tboneATL/covid-19-response/media/31mar1.png

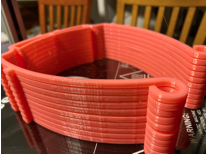
media/31mar1.png
