tboneATL/covid-19-response/media/GMT2.jpg

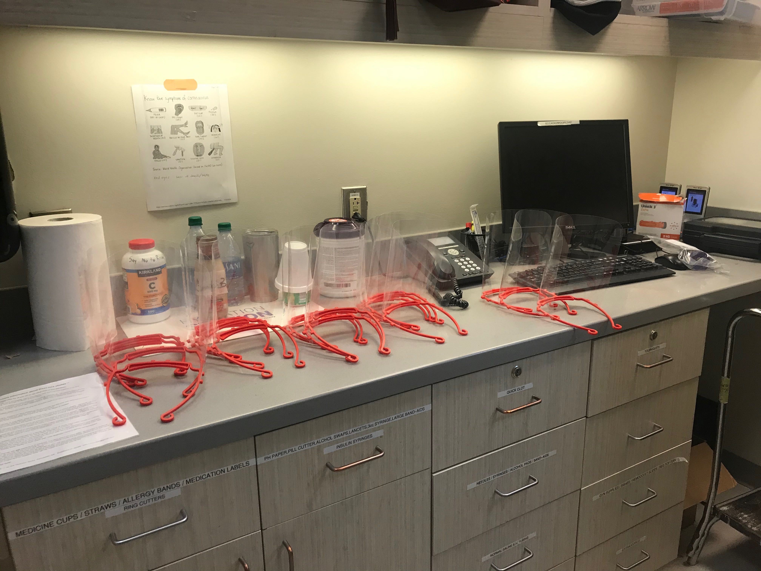
media/GMT2.jpg
