tboneATL/covid-19-response/README.md

# Be safe



## Please visit https://tboneatl.github.io/covid-19-response/ to understand what this is and what this isn't before printing/distributing anything from this repo.
