tboneATL/covid-19-response/shield-designs-for-cutting/Face-Shield-v2.pdf

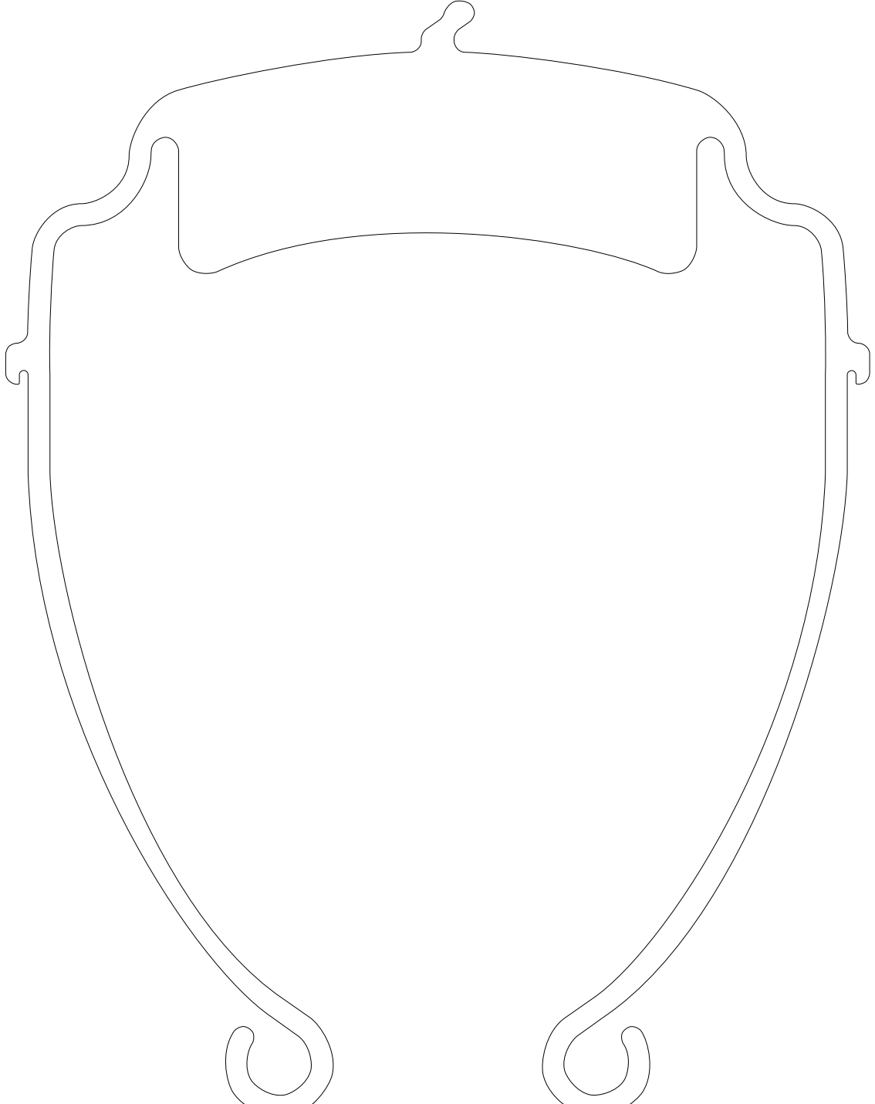
[picture p3: figure]
