tboneATL/covid-19-response/media/1apr.png

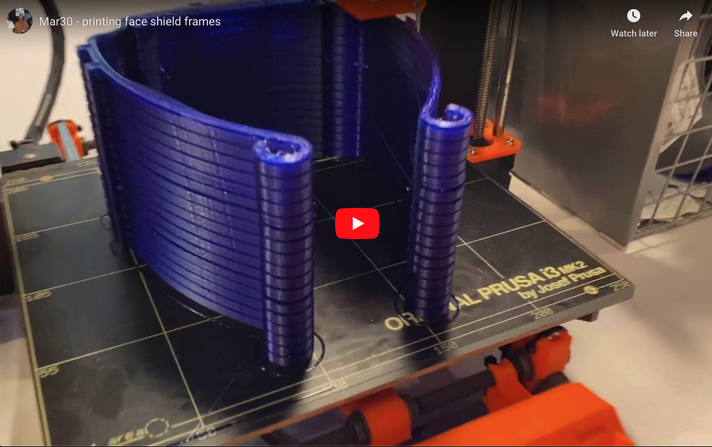
media/1apr.png
