tboneATL/covid-19-response/media/19mar.png

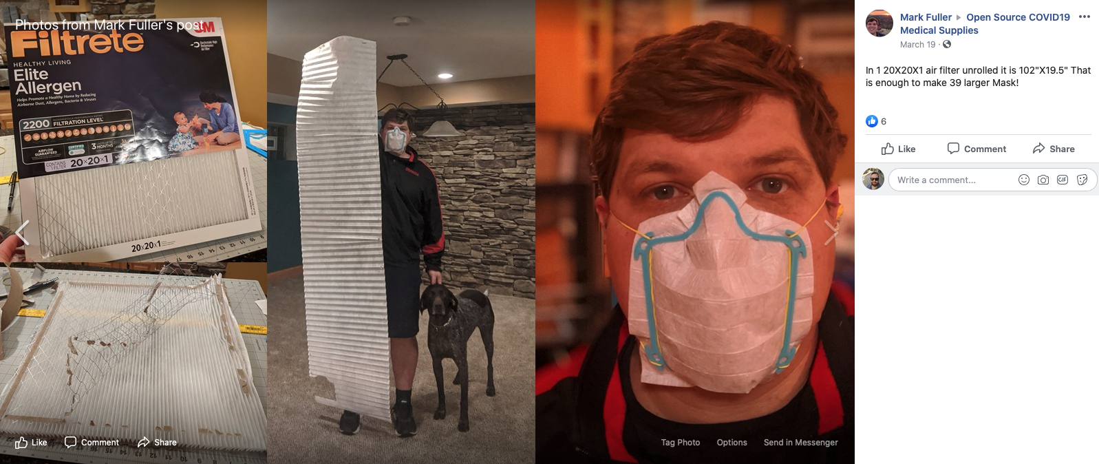
media/19mar.png
