tboneATL/covid-19-response/media/27mar1.png

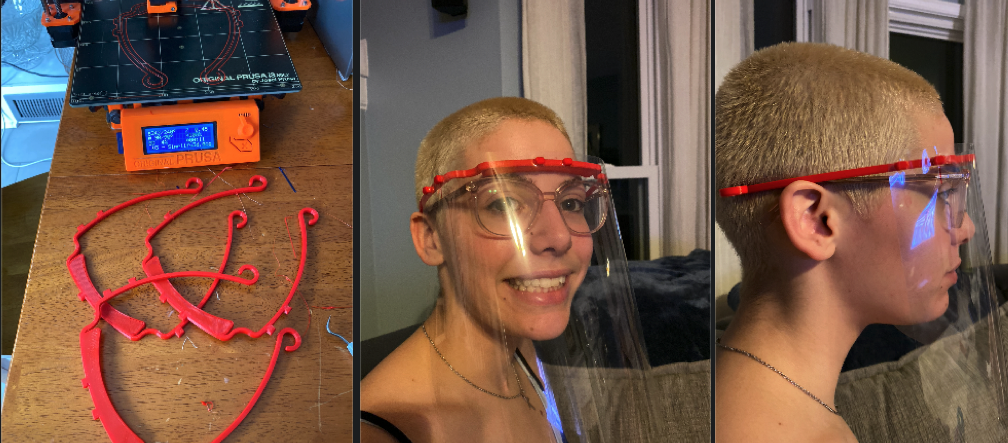
media/27mar1.png
