tboneATL/covid-19-response/media/27mar2.png

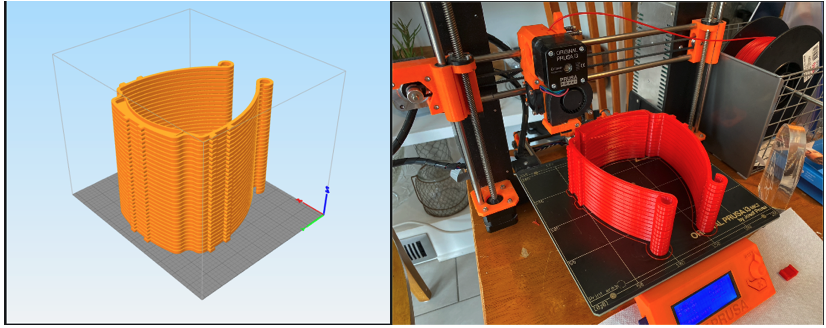
media/27mar2.png
