tboneATL/covid-19-response/media/28mar1.png

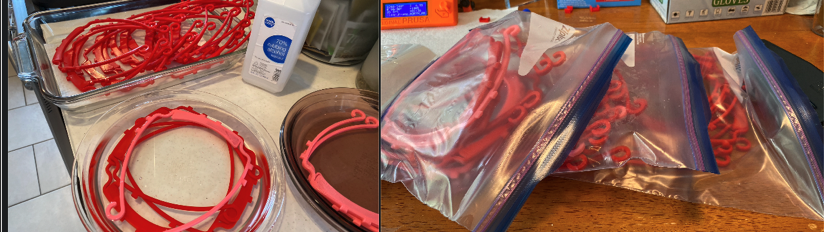
media/28mar1.png
