tboneATL/covid-19-response/media/28mar2.png

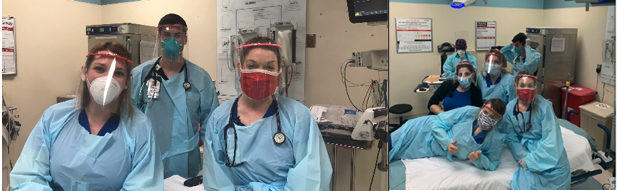
media/28mar2.png
