tboneATL/covid-19-response/media/29mar1.png

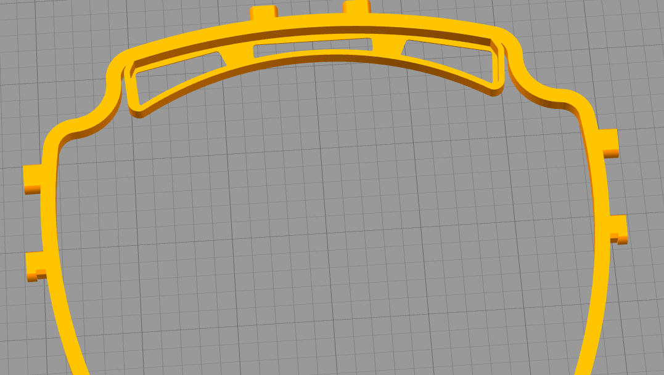
media/29mar1.png
