tboneATL/covid-19-response/media/29mar2.png

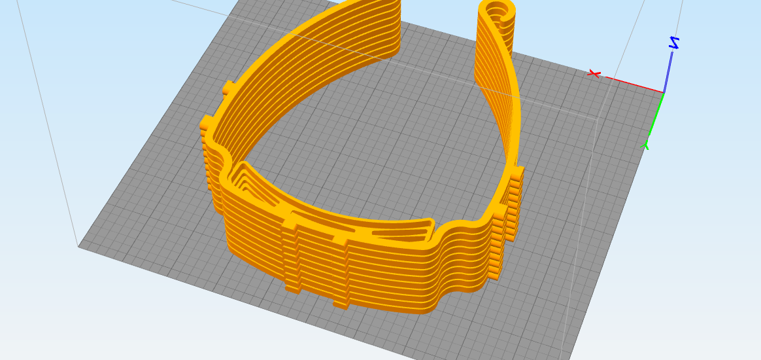
media/29mar2.png
