tboneATL/covid-19-response/media/30mar1.png

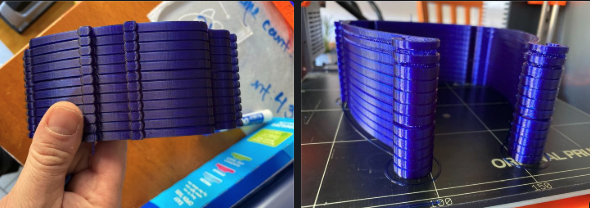
media/30mar1.png
