tboneATL/covid-19-response/media/30mar2.png

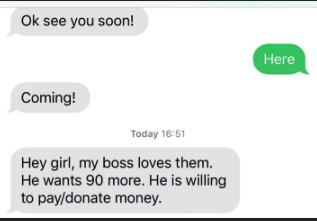
media/30mar2.png
