tboneATL/covid-19-response/media/30mar3.png

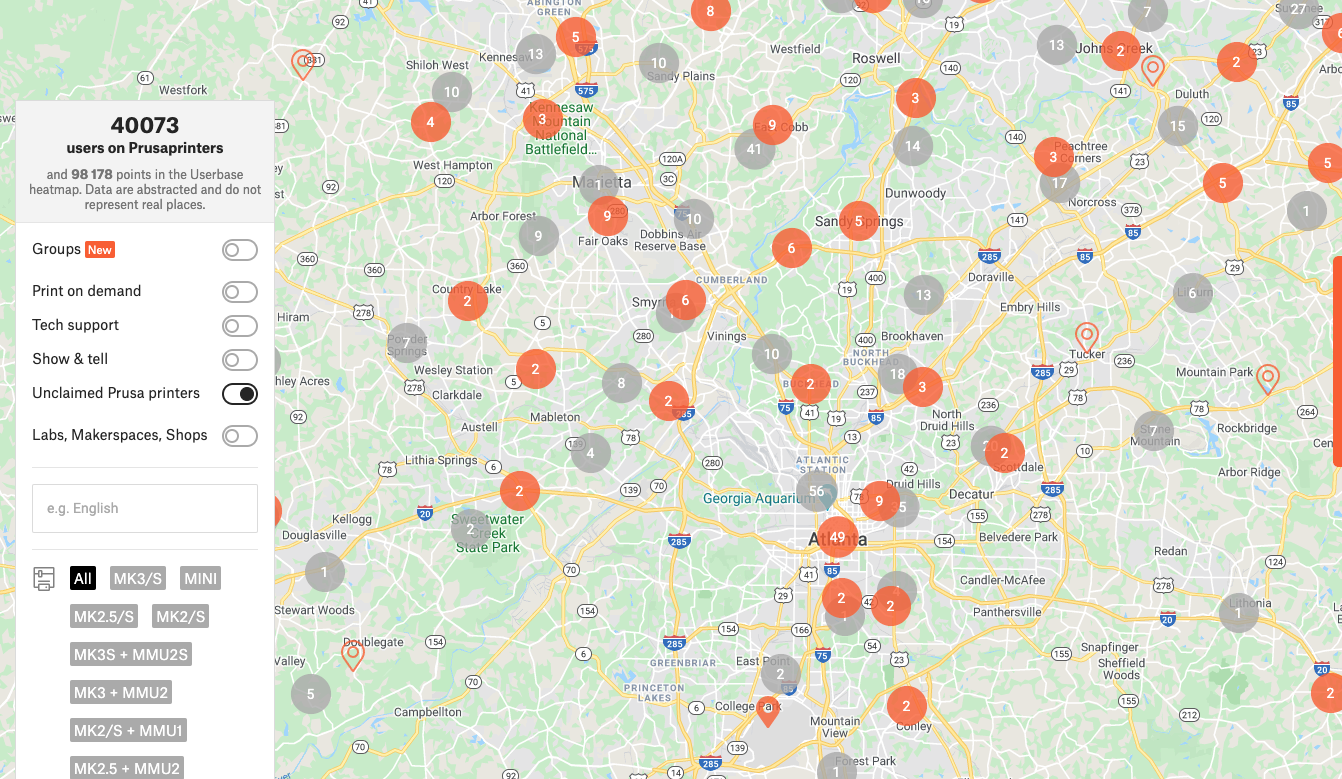
media/30mar3.png
