tboneATL/covid-19-response/media/31mar2.png

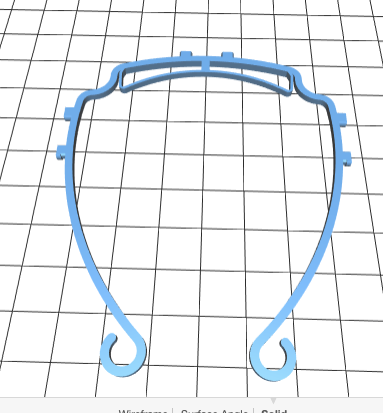
media/31mar2.png
