tboneATL/covid-19-response/media/31mar3.png

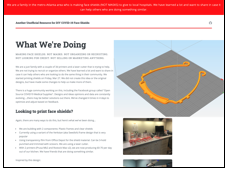
media/31mar3.png
