tboneATL/covid-19-response/media/GMT1.jpg

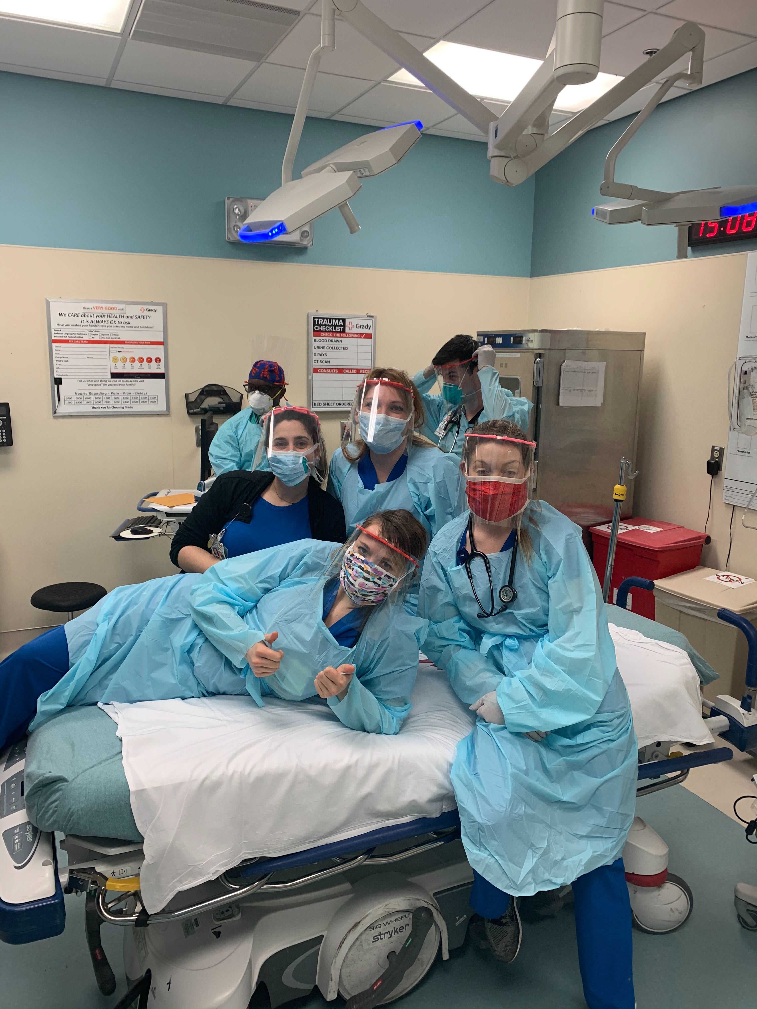
media/GMT1.jpg
