tboneATL/covid-19-response/media/GMT3.jpg

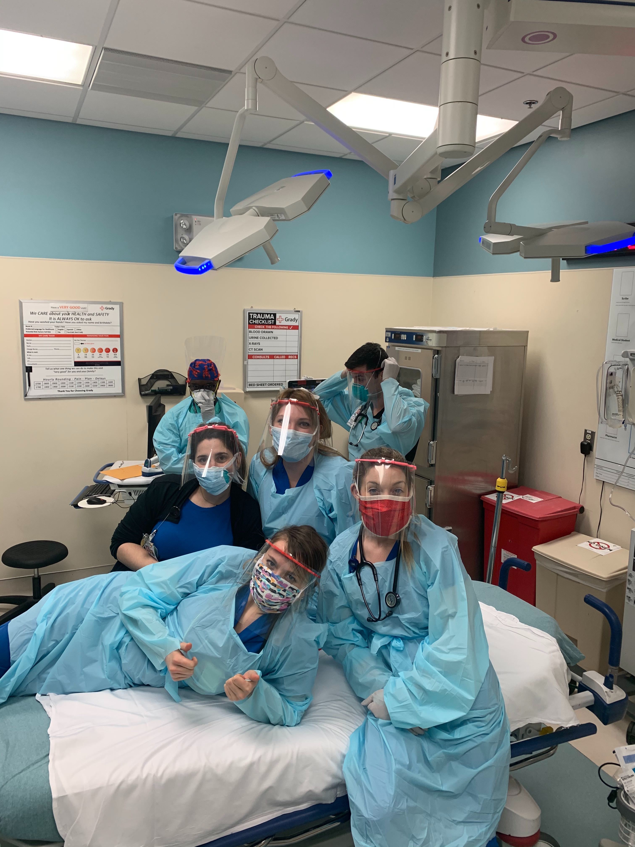
media/GMT3.jpg
