tboneATL/covid-19-response/media/GMT4.jpg

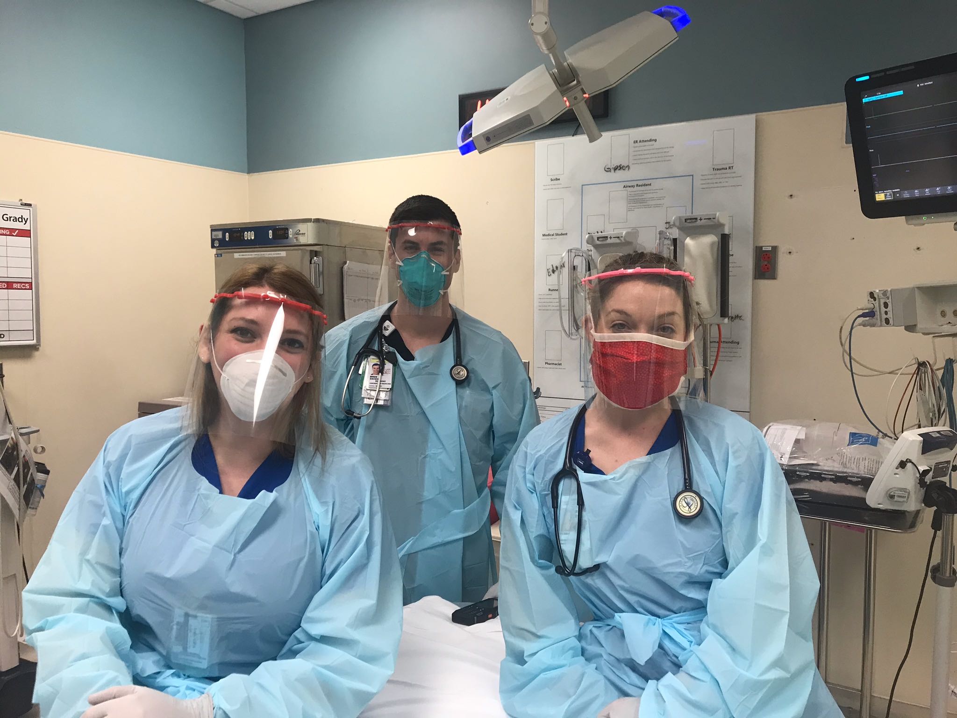
media/GMT4.jpg
