tboneATL/covid-19-response/media/protoshield.png

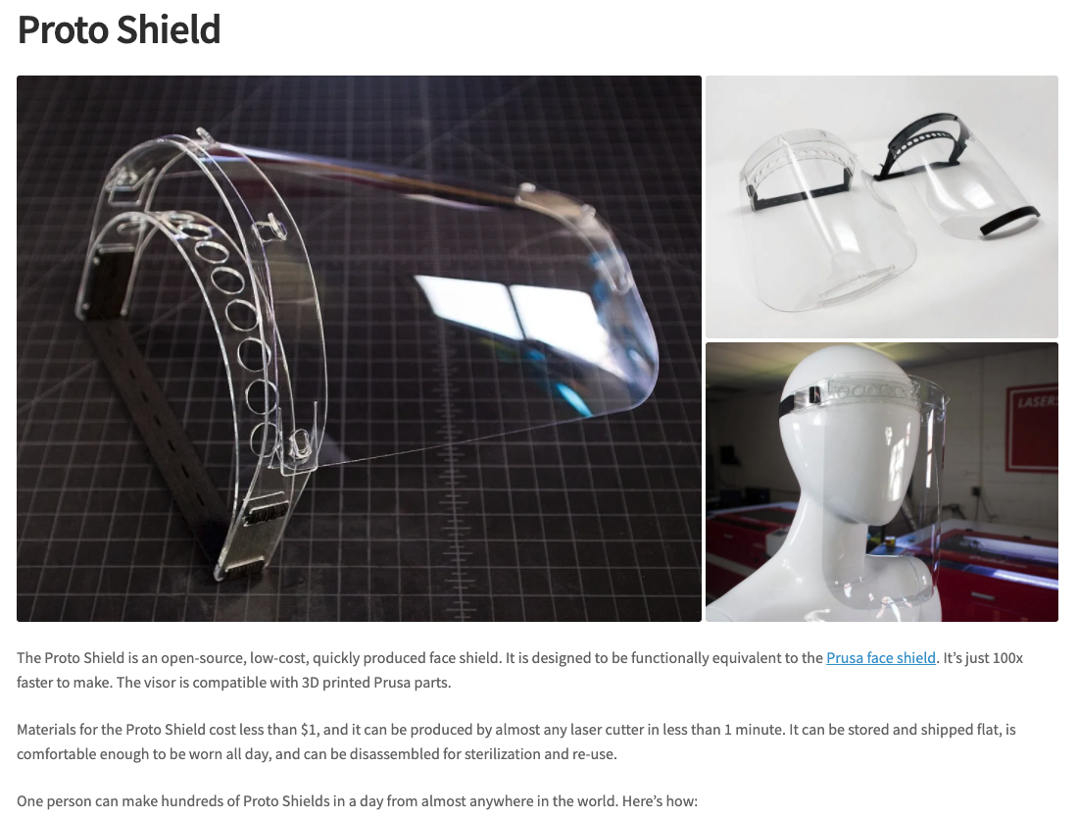
media/protoshield.png
