tboneATL/covid-19-response/media/prusaRC3img.png

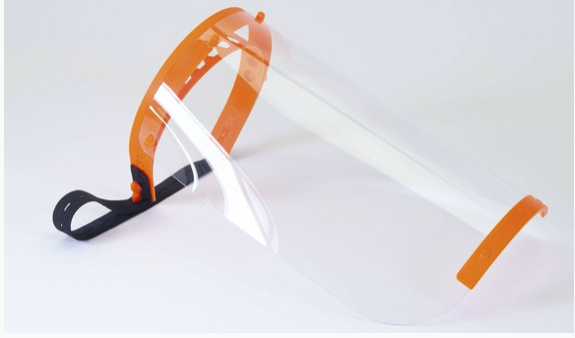
media/prusaRC3img.png
