tboneATL/covid-19-response/media/THS4.jpg

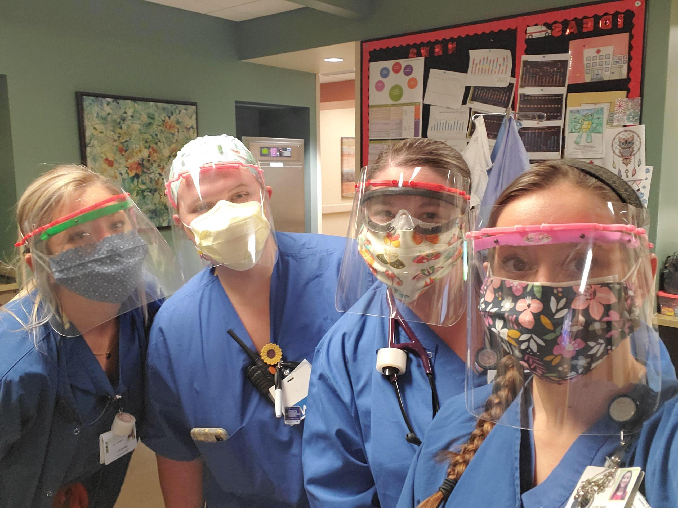
media/THS4.jpg
