tboneATL/covid-19-response/media/zaccaframe.png

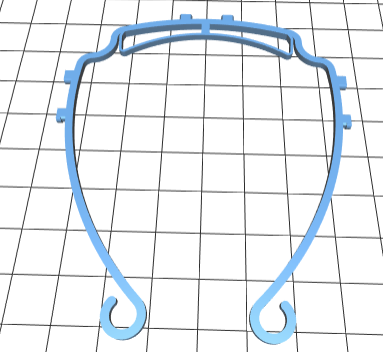
media/zaccaframe.png
