tboneATL/covid-19-response/shield-designs-for-3d-printing/Caskey-Remix/STLs/Caskey Visor Frame single.stl

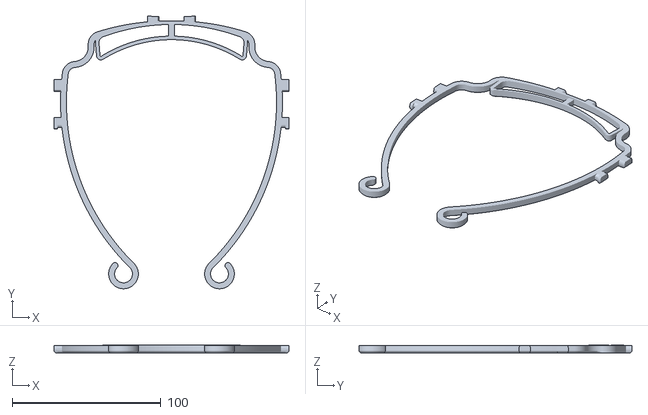
[picture p24: CAD file, 2020-04-02]
shield-designs-for-3d-printing/Caskey-Remix/STLs/Caskey Visor Frame single.stl
158.0 x 183.3 x 5.40
