tboneATL/covid-19-response/shield-designs-for-3d-printing/Prusa-Shield/covid19_headband_rc3.stl

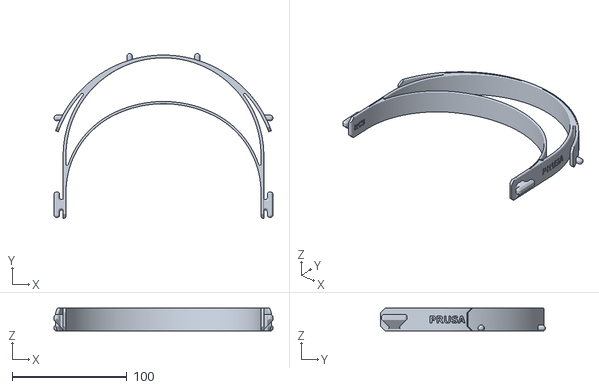
[picture p26: CAD file, 2020-03-29]
shield-designs-for-3d-printing/Prusa-Shield/covid19_headband_rc3.stl
191.0 x 143.8 x 20.0
