tboneATL/covid-19-response/shield-designs-for-3d-printing/Verkstan-Shield/2UP_Visor_Frame_NORTH_AMERICA_LETTER_v3.stl

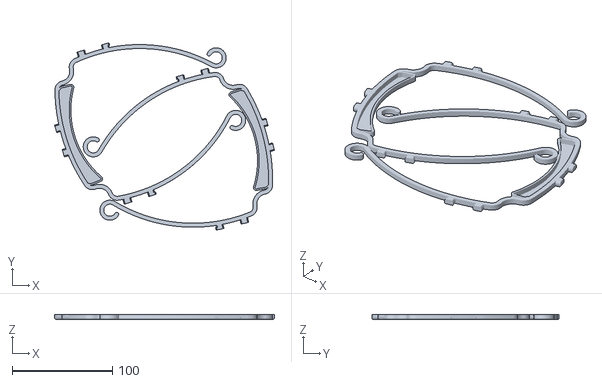
[picture p27: CAD file, 2020-03-30]
shield-designs-for-3d-printing/Verkstan-Shield/2UP_Visor_Frame_NORTH_AMERICA_LETTER_v3.stl
219.0 x 186.6 x 5.00
