tboneATL/covid-19-response/shield-designs-for-3d-printing/Zaccanigno-Remix/Zacca_Remix2_of_Verkstan_NA.stl

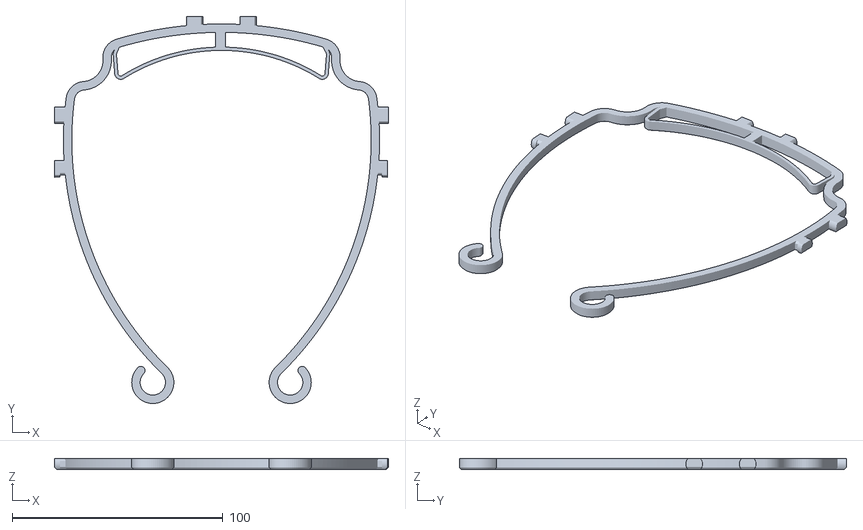
[picture p28: CAD file, 2020-03-31]
shield-designs-for-3d-printing/Zaccanigno-Remix/Zacca_Remix2_of_Verkstan_NA.stl
158.5 x 183.6 x 5.00
