tboneATL/covid-19-response/shield-designs-for-3d-printing/Caskey-Remix/STLs/Caskey Visor Frame 10.stl

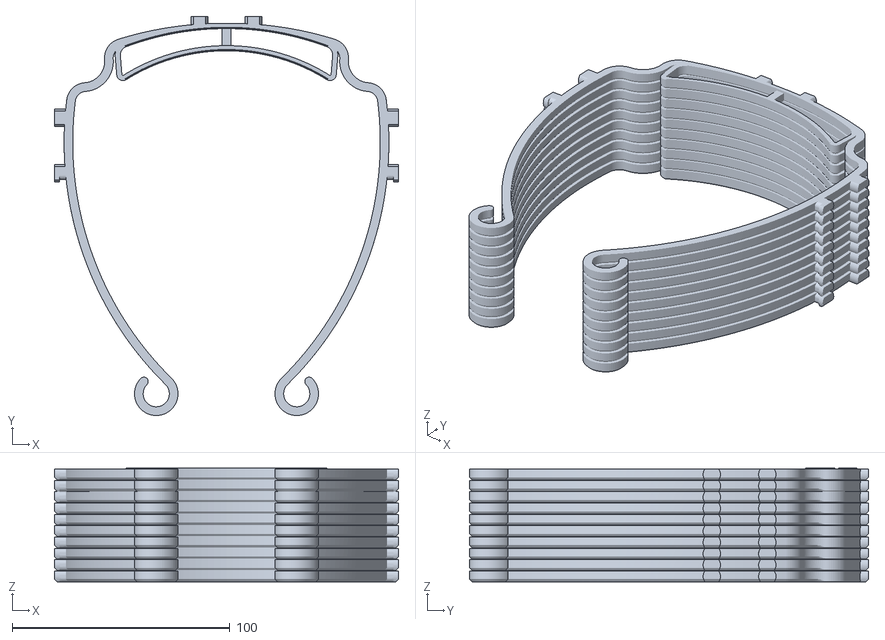
[picture p29: CAD file, 2020-04-01]
shield-designs-for-3d-printing/Caskey-Remix/STLs/Caskey Visor Frame 10.stl
158.0 x 183.3 x 52.2
