tboneATL/covid-19-response/shield-designs-for-3d-printing/Caskey-Remix/STLs/experimental-ET/5Stack_Caskey_Remix.stl

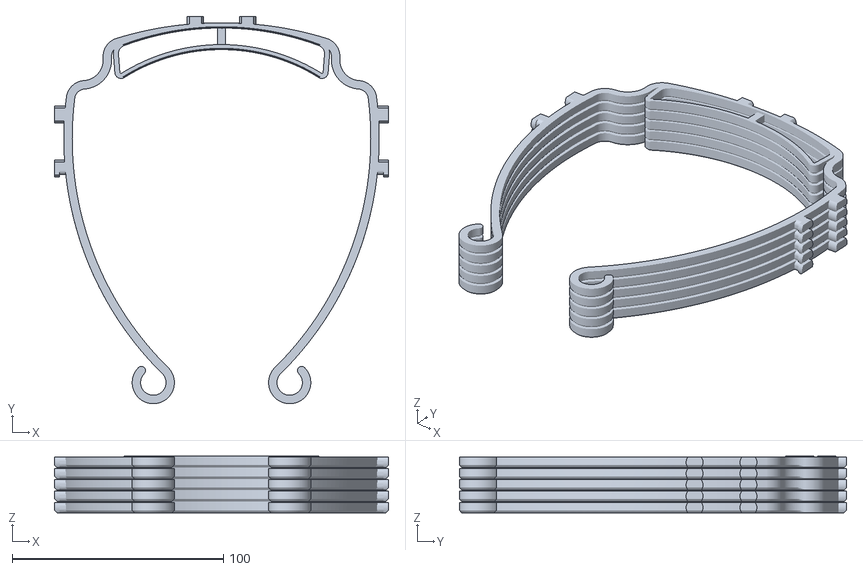
[picture p30: CAD file, 2020-04-03]
shield-designs-for-3d-printing/Caskey-Remix/STLs/experimental-ET/5Stack_Caskey_Remix.stl
158.0 x 183.3 x 26.8
