tboneATL/covid-19-response/shield-designs-for-3d-printing/Verkstan-Shield/Visor_Frame_NORTH_AMERICA_LETTER_v3.stl

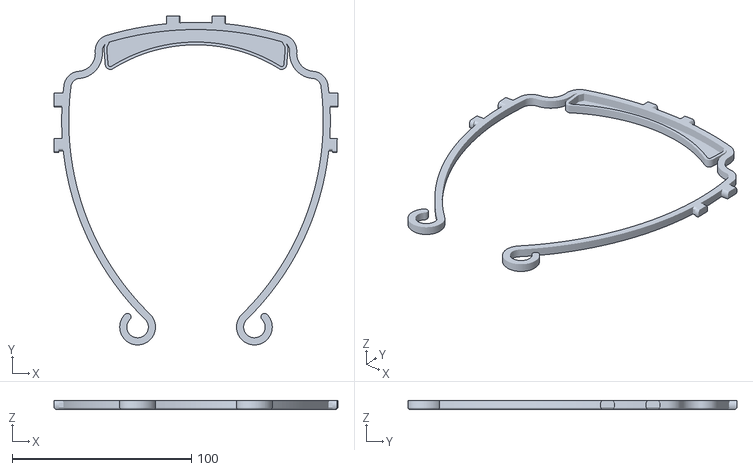
[picture p31: CAD file, 2020-03-29]
shield-designs-for-3d-printing/Verkstan-Shield/Visor_Frame_NORTH_AMERICA_LETTER_v3.stl
158.5 x 183.6 x 5.00
