tboneATL/covid-19-response/(list of files, cad)

Other CAD files:
Shield Designs for 3D printing/Verkstan-Shield/.STACKED_Visor_Frame_NORTH_AMERICA_LETTER_v3.stl
Shield Designs for 3D printing/Zaccanigno Remix/.10Stacked_Zacca_Remix_of_Verkstan_NA_Frame.stl
shield-designs-for-cutting/shield 1up segments.dxf
Shield Designs for 3D printing/Verkstan-Shield/Visor_Frame_NORTH_AMERICA_LETTER_v3.step
shield-designs-for-3d-printing/Zaccanigno-Remix/Zacca_Remix_of_Verkstan_NA_frame.stl
shield-designs-for-3d-printing/Zaccanigno-Remix/good-but-old/Zacca_Remix_of_Verkstan_NA_frame.stl
shield-designs-for-3d-printing/Zaccanigno-Remix/huhZacca_stacka.scad
shield-designs-for-3d-printing/Zaccanigno-Remix/nStacked_Zacca_Remix_of_Verkstan_NA_frame.scad
shield-designs-for-3d-printing/Zaccanigno-Remix/Zacca_stacka.scad
Shield Designs for 3D printing/Verkstan-Shield/STACKED_Visor_Frame_NORTH_AMERICA_LETTER_v3.stl
Shield Designs for 3D printing/Zaccanigno Remix/10Stacked_Zacca_Remix_of_Verkstan_NA_Frame.stl
shield-designs-for-3d-printing/Caskey-Remix/Src/Caskey Visor Frame.f3d
