tboneATL/covid-19-response/shield-designs-for-3d-printing/README.md

# Latest 

## NOTE: We are currently seeing mixed results with this model. PETG is difficult to separate without breaking for us.  PLA is working.  Anyone trying to print a stacked version of this should test first.  (Kill a print after 2 or 3 have printed and pull them apart.  If it works, you have a few usable frames and can print a full stack with more confidence.)

### Best current design set working for us:  Caskey-Remix (see above) and Zacca Remix2



### Stacking for the win!
Stacking this type of print is the best approach for us.  Instead of having to babysit the printer and swap out prints every hour or so, we've been able to set it and forget it.  It's been very handy for overnight prints.  As described below, there has been some tweaking and there may be some more to come.

### Stacking isn't always easy though 

Lessons learned:
1. Get your printer working well for a single print
2. Slice your stack and set the print and let it run long enough to print at least 2 as a test.  The best part of a stack is you can stop it at any time and only lose the top unit.  This is great for testing, power surge, running out of filament, crash, etc.

  
Zacca Remix2 Stacked (20)

<br /><br />

More detail on how we came to this design:

https://github.com/tboneATL/covid-19-response/issues/1

|Current |Date |Style  | 
|---  |---|---|
| X  |Apr 2 | Caskey Remix  | 
| X |Mar 31 | Zacca Remix2  | 
| |Mar 30 | Zacca Remix  | 
| |Mar 28 | Verkstan  | 
| |Mar 27 | Prusa RC3 |
