tboneATL/covid-19-response/shield-designs-for-3d-printing/Caskey-Remix/README.md

@rsparkyc - contributed this modification of the Zacca2 Remix.  It has chamfered tops to help with stacking.  

See [this thread](https://github.com/tboneATL/covid-19-response/issues/1) for more detail.
