tboneATL/covid-19-response/(threads)

Thread 1 (2020-03-30):

Batch with clear PETG

rsparkyc, 2020-03-30:
I have some clear PETG that I can use, I'll provide updates here as to how they turn out. I'm starting with this stacked design: https://github.com/tboneATL/covid-19-response/blob/master/Shield%20Designs%20for%203D%20printing/Verkstan-Shield/STACKED_Visor_Frame_NORTH_AMERICA_LETTER_v3.stl

tboneATL, 2020-03-30:
hey @rsparkyc  - good to hear from you.  I've printed a few stacks of that one, and they come apart pretty easily, but sometimes have issues with bridging, so you might want to keep an eye on them.  Even the ones that have problems with bridges are functionally usable IMHO

Please let me know how you make out with it.  Thanks for helping!

rsparkyc, 2020-03-30:
@tboneATL This clear PETG has never like to stick to my build plate, I might actually experiment NOT printing on glass for this (I've only ever printed on glass)

tboneATL, 2020-03-30:
@rsparkyc  - yeah, PETG is new for me too.  Which printer do you have?  Also, PETG is generally preferred but PLA is viable too.  We're sending both out.

rsparkyc, 2020-03-30:
@tboneATL Yeah, I gotta use up this clear PETG, also have some glow in the dark PLA, that might be fun :). I'm printing on the Ender 3, but custom printed my own direct drive mod.

rsparkyc, 2020-03-31:
Got about 5 done before the printer went crazy, and I see what you mean about the bridging sometimes stringing. I'm actually going to try printing it upside down and see what happens.

tboneATL, 2020-03-31:
Here's what I know about stacking:

Yesterday, I printed the Verkstan Stacked .stl that I got from here: https://github.com/CarlosGS/facemask-print-vertical

It ran for about 17 hours or so and I got 22-23 usable prints from it.
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

However, because of the solid brow piece, some of the plates fell through.  Still works from a structural point of view, but definitely not pretty - lots of gaps.
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

This is a modified design intended to be faster to produce and more "stack-friendly".  I'm calling it the "Zacca" mod after the guy who changed the file for me. When printed one-off, it's not bad:
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

@elenathornton followed the instructions from the first link ☝️ and it looked great after printing:
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

There was still some ugliness on the inside, but I would say it's a success...
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

HOWEVER...
I've printed 2 stacks of the red ones...maybe 35 total (original design) and 1 stack of the new design. All of the red ones separated easily from the stack after printing.  On the blue ones, the legs separated ok, but the brow pieces were really stuck together.  I ended up breaking several while pulling them apart... :-(
I'm working on my technique for separating them but I want to figure out why there's such a drastic difference between the 2 stacks.  I think until I figure this out, I'll continue to use the original stack design (red ones).

rsparkyc, 2020-03-31:
Here are some of my results. I couldn't get them to print more than about 4-5 high without having some sort of failure. My first batch was printed in the same orientation as the STL, but had the same issues with bridging that you had. This picture is after some cleanup I did where I had stringing across the brow piece (obviously not desirable - you can still see some on the 2nd print on the top left)

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

Then, I tried flipping the STL over, and got good results on that part, but had stringing on the legs of the print. This failed when the legs of the top print started warping up from the rest of the stack, probably because of poor adhesion to the lower level due to that stringing.

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

I'm printing at a .44 line width, .28 layer height, 2 walls, but maybe I'll tweak that and see what results I get.

rsparkyc, 2020-03-31:
Edit: now that I'm looking at the STL a bit closer, I see why I'm getting more stringing, there's a taper on only one side of the model. I wonder if I can do some editing...

tboneATL, 2020-03-31:
hmm.. good stuff @rsparkyc  - these still look usable.  I had some good results with the Zacca Remix stacks I ran overnight.  I got 16 in 5 hours.  Not as much stringing.  You might try those.

rsparkyc, 2020-03-31:
I'm actually going to try making some more modifications, need to model this first @tboneATL
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

rsparkyc, 2020-03-31:
Ok, trying out a new design - chamfer on both the top and bottom, and the bridging layer is in the middle of the model, instead of at the top/bottom - should make sure there's adequate walls to connect the bridge regardless of the print orientation. I have a stack of 10 with 0.2mm gaps between, so we'll see what happens if i print at a 0.2 layer height

tboneATL, 2020-03-31:
@rsparkyc  - try this one:
https://github.com/tboneATL/covid-19-response/blob/447a3f886010a54e3c9fd5ba876067fe108eb029/shield-designs-for-3d-printing/Zaccanigno-Remix/untested/Zacca_Remix2_Ver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

I'll be working on stacked versions soon and will let you know

rsparkyc, 2020-03-31:
@tboneATL I can already tell that one will print better. I think the problem you were having with the other modified one is that in all other layers but the first one, you were probably doing some in-air printing if you weren't using any support for the thin area by the forehead - that's why the filled in one works so well, it can bridge the complete gap. The one you linked should also be able to bridge just fine. I did notice that having a chamfer on the top and bottom makes the 2nd layer have a lot of stringing on the arms, it seems like the extra width of the printed piece on the bottom compared to the chamfered bottom of the new one helps compensate for the gap you introduce in the stacked model.

tboneATL, 2020-04-01:
@rsparkyc - I'm seeing good results so far on the new stack.  I moved them from the untested folder, up a level.

I recommend printing the Zacca Remix 10 or 20 stack.

rsparkyc, 2020-04-01:
Yeah, I think I’ll try that next. I’m getting good results with the one I
customized as well, so this is all looking promising.

On Tue, Mar 31, 2020 at 21:43 Toby Thornton <notifications@github.com>
wrote:

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
--
-Ryan

tboneATL, 2020-04-01:
Awesome -
In case anyone else is looking:

https://github.com/tboneATL/covid-19-response/tree/master/shield-designs-for-3d-printing/Zaccanigno-Remix

rsparkyc, 2020-04-01:
My stack of 10 printed this morning, also good results.  Here's a picture of the stack, and the 4 worst offenders.
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

I'm going to try a stack of 10 of the one you suggested, but I also have some ideas about how I could add a ridge on the tops of them to prevent the delamination and stringing that i'm seeing along the brow (while still letting them come apart easily). I'll see if that's necessary after trying the Zacca remix.

rsparkyc, 2020-04-01:
Here's a picture of the idea I'm having to prevent that stringing on that brow piece, I might try it depending on how these others turn out:
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

rsparkyc, 2020-04-01:
another view, stacked, and with a double lip
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

rsparkyc, 2020-04-01:
Actually, just started the 2nd piece in the stack and already saw some bad stringing on the other model. He has a layer gap of 0.35, where I was using 0.2, so I think that may be why it strung more.
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

rsparkyc, 2020-04-01:
Created PR with my design here, we'll see how this latest update prints: https://github.com/tboneATL/covid-19-response/pull/5

Thread 6 (2020-04-01):

Open vs Closed designs

rsparkyc, 2020-04-01:
In doing more reading, I saw there's a debate for open vs closed designs, and I know you mentioned that open would be better as far as print speed, material usage, and stackability. I wanted to address those points

1. Print speed: Probably true, but the more complex your cutouts are, the more surface area you're going to be printing, thus more walls. The best design I saw for open (while still having some support) in the latest from Zacca. I copied this over to my design

1. Material Usage: no brainer here

1. Stackability: I know the original design had some issues with the closed section printing successfully but still allowing pieces to seperate. I found that this was mainly because it was on the bottom layer. If any of the walls did not form properly on that first layer, you'd run into issues, and because these walls were printed after a larger z-step (to aid in the pieces removal), there was a high chance they might have some abnormalities. One design I tested had the closed section moved in the middle of the height of the model. This allowed there to be good wall support on lower layers, and I had 0 issues when I printed a stack of 10 (at least in regard to separation and the solid section forming). If it turns out that it's better to have that closed section in place, this is probably a viable option.

Attached you will find some of my "bad" prints with the closed design. While there's some stringing on the walls, the closed area seems to have worked great. I'm currently testing a design now that may help remove that wall stringing, and this strategy can be applied to both open and closed designs.

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
