tboneATL/covid-19-response/(commit log)

2020-03-29 added STEP
    [Visor_Frame_NORTH_AMERICA_LETTER_v3.step]
2020-03-30 changed model files to Binary for easier downloading
    [10Stacked_Zacca_Remix_of_Verkstan_NA_Frame.stl, 2UP_Visor_Frame_NORTH_AMERICA_LETTER_v3.stl, TEST-DO-NOT-USE.stl, Zacca_Remix_of_Verkstan_NA_frame.stl, Zacca_Visor_Frame_NORTH_AMERICA_LETTER_v3-Modified-1.stl]
2020-03-30 fixed binary files
    [10Stacked_Zacca_Remix_of_Verkstan_NA_Frame.stl]
2020-03-30 removed icloud garbage
    [.10Stacked_Zacca_Remix_of_Verkstan_NA_Frame.stl, .STACKED_Visor_Frame_NORTH_AMERICA_LETTER_v3.stl]
2020-03-30 more icloud cleanup
    [10Stacked_Zacca_Remix_of_Verkstan_NA_Frame.stl, STACKED_Visor_Frame_NORTH_AMERICA_LETTER_v3.stl]
2020-03-31 Site files + updated zacca stacks
    [nStacked_Zacca_Remix_of_Verkstan_NA_frame.scad]
2020-03-31 .ds store
    [Zacca_stacka.scad, verticalstack.scad]
2020-03-31 changed dir names to remove spaces
    [2UP_Visor_Frame_NORTH_AMERICA_LETTER_v3.stl, Visor_Frame_NORTH_AMERICA_LETTER_v3.stl, Zacca_Remix_of_Verkstan_NA_frame.stl, Zacca_stacka.scad, covid19_headband_rc3.stl, nStacked_Zacca_Remix_of_Verkstan_NA_frame.scad, verticalstack.scad]
2020-04-01 added Zacca Remix2 files
    [Zacca_Remix2_of_Verkstan_NA.stl, Zacca_stacka.scad, huhZacca_stacka.scad]
2020-04-01 promoting Remix2 to proven.
    [Zacca_Remix2_of_Verkstan_NA.stl, Zacca_stacka.scad]
2020-04-01 renamed scad file
    [Zacca_stacka.scad]
2020-04-01 Create printers page, refine index
2020-04-01 changed case of media folder
2020-04-01 stubbing out buttons
2020-04-01 added my shield design
    [Caskey Visor Frame v1.f3d, Caskey Visor Frame.stl]
2020-04-01 renamed file
    [Caskey Visor Frame.f3d]
2020-04-01 reorg files, fix ASCII >>Binary
    [Zacca_Remix_of_Verkstan_NA_frame.stl, verticalstack.scad]
2020-04-02 did some renames, added 20 and single designs
    [Caskey Visor Frame 10.stl, Caskey Visor Frame single.stl]
2020-04-02 updated current print
    [Caskey Visor Frame 10.stl, Caskey Visor Frame single.stl, Caskey Visor Frame.f3d]
2020-04-03 adding cut files
    [shield 1up segments.dxf]
2020-04-03 Upload 10+20 stack of caskey remix through openscad
    [10Stack_Caskey_Remix.stl, 5Stack_Caskey_Remix.stl]
